SengerM/tct_readout_board_passive_4_channels/art.png

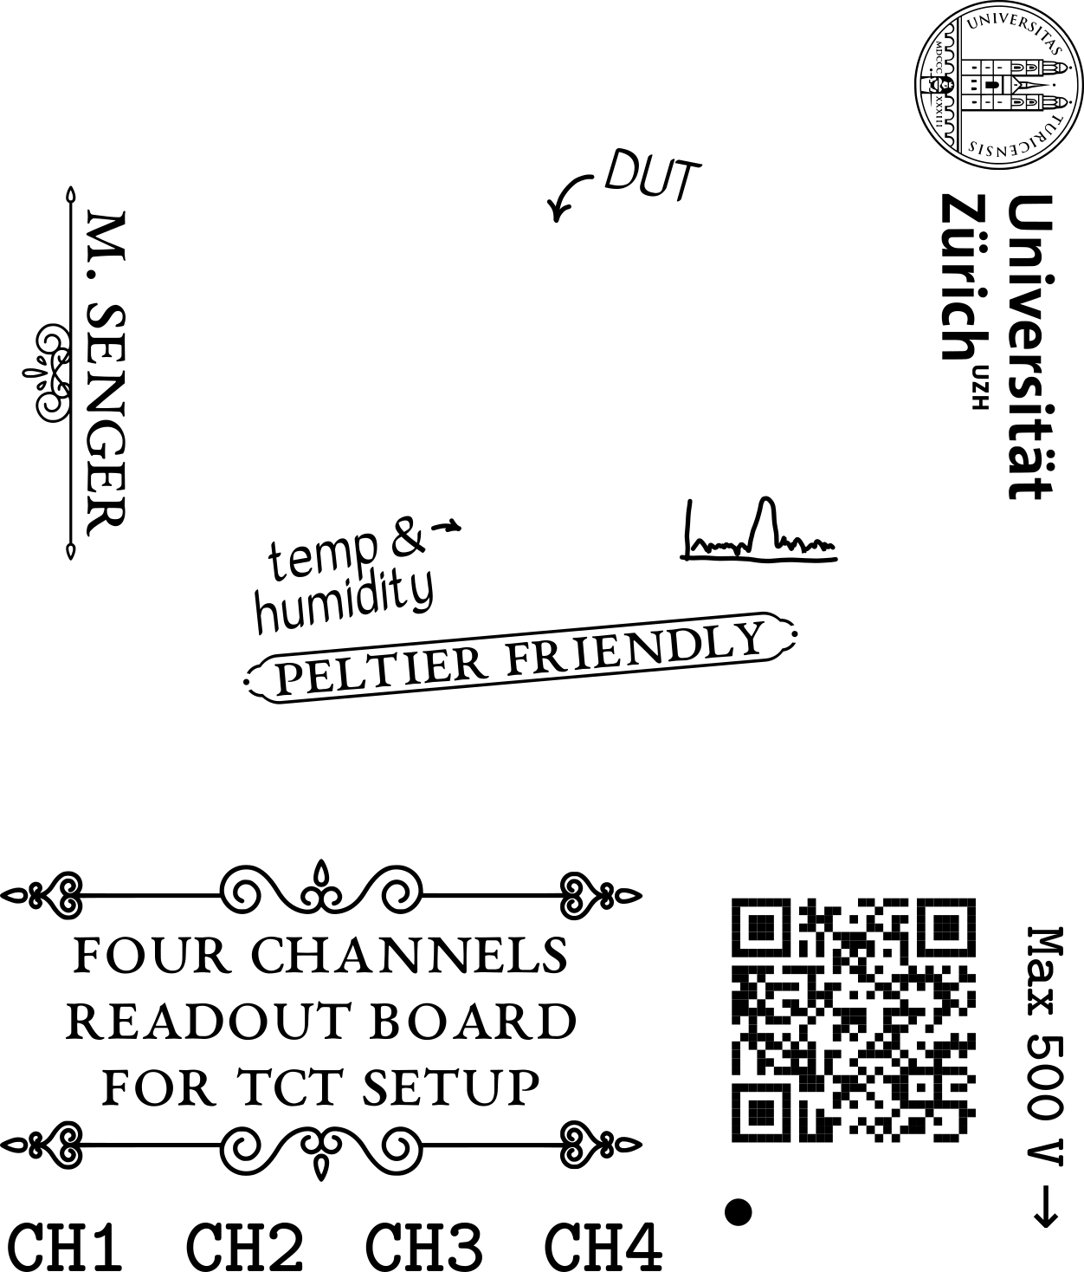
art.png
