SengerM/tct_readout_board_passive_4_channels/3D_models/pcb_connector_850-80-004-40-251101.stp

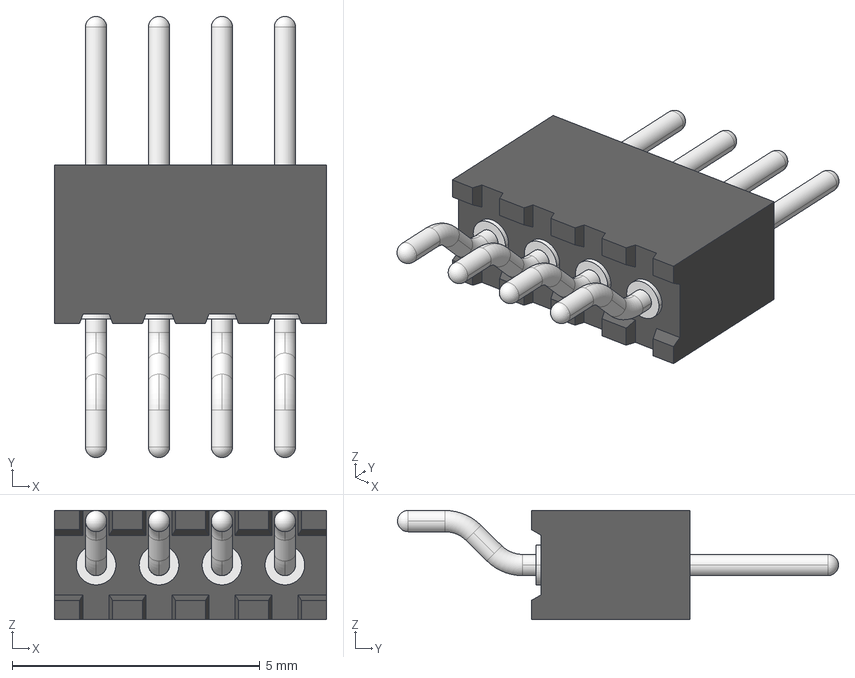
[picture p3: CAD file, 2021-10-01]
3D_models/pcb_connector_850-80-004-40-251101.stp
5.49 x 8.90 x 2.20 mm
