SengerM/tct_readout_board_passive_4_channels/3D_models/MMCX-J-P-H-RA-TH1.stp

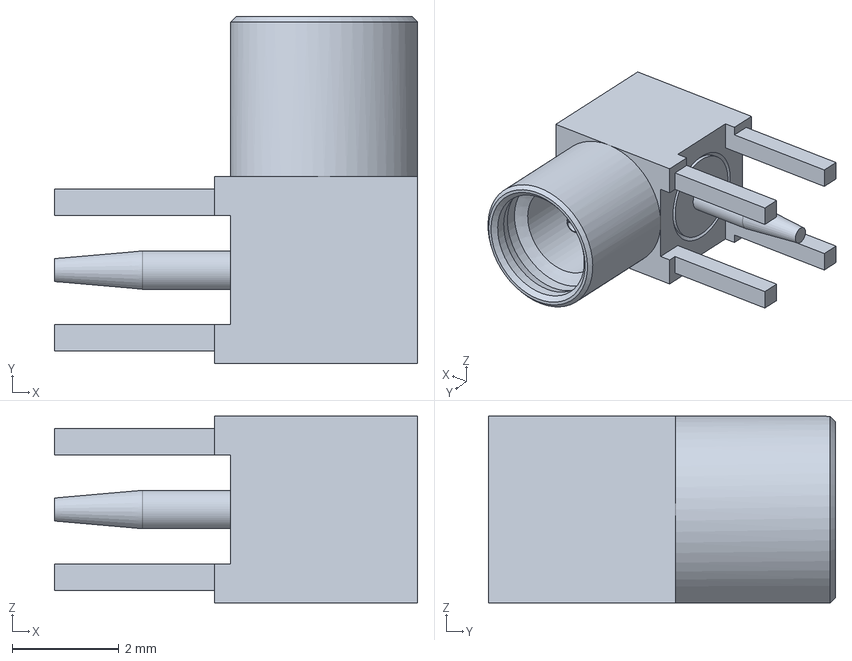
[picture p4: CAD file, 2021-10-01]
3D_models/MMCX-J-P-H-RA-TH1.stp
6.80 x 6.50 x 3.50 mm
