SengerM/tct_readout_board_passive_4_channels/(commit log)

2021-10-01 Version 1
    [MMCX-J-P-H-RA-TH1.stp, pcb_connector_850-80-004-40-251101.stp, readout_board_for_TI-LGAD.kicad_pcb, readout_board_for_TI-LGAD.sch]
2021-10-02 Added Achim's suggestions
    [readout_board_for_TI-LGAD.kicad_pcb]
2021-10-02 Added RF shield
    [readout_board_for_TI-LGAD.kicad_pcb, readout_board_for_TI-LGAD.sch]
2021-10-04 Now using a smaller RF shield
    [readout_board_for_TI-LGAD.kicad_pcb, readout_board_for_TI-LGAD.sch]
2022-01-05 Added link to datasheet
    [readout_board_for_TI-LGAD.sch]
2022-02-16 Changed grid origin to the center of the PCB
    [readout_board_for_TI-LGAD.kicad_pcb]
