SengerM/tct_readout_board_passive_4_channels/(notices)

Notices in the files:
3D_models/MMCX-J-P-H-RA-TH1.stp:
FILE_NAME( 'e:/temp/worker_238/temp/exporttempdir_1804_1036_l1MQE/format_0/MMCX-J-P-H-RA-TH1.stp', '2021-09-29T19:57:45', ( 'License CC BY-ND 4.0' ), ( 'CADENAS' ), ' ', 'PARTsolutions', ' ' );
